rhkean/kicad_ESP32-S3_D1_Pico/ESP32-S3 Pico D1.kicad_pcb

## KiCad design ESP32-S3 Pico D1.kicad_pcb (2026-06-14)

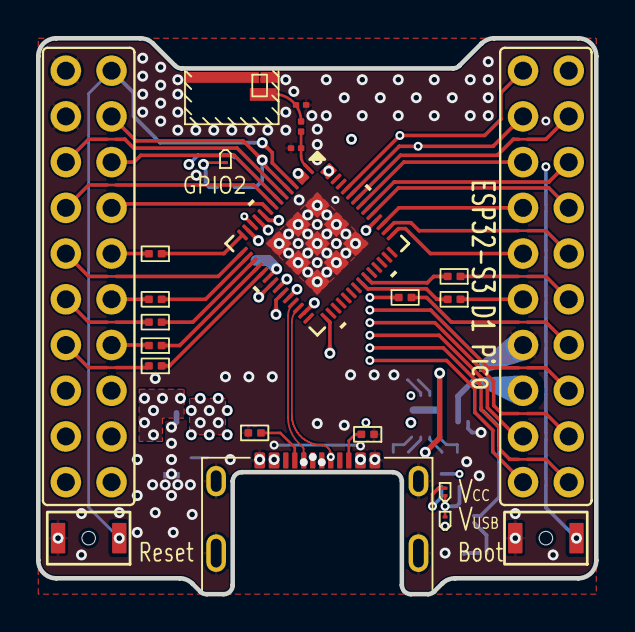
[picture p1: board ESP32-S3 Pico D1.kicad_pcb from above]

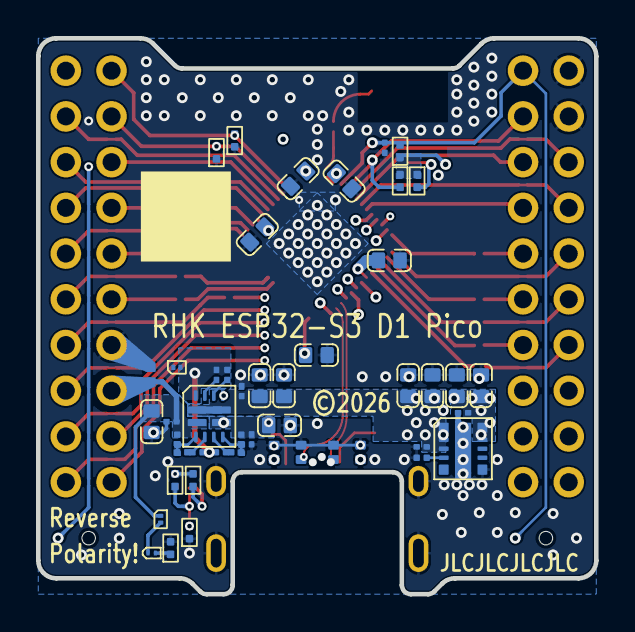
[picture p2: board ESP32-S3 Pico D1.kicad_pcb from below]

Board: 6 copper layers, 31.0 x 30.9 mm, 69 parts (47 on the bottom side), 65 nets.

Parts:
ANT401: 2450AT07A0100; Chip Antenna 0402
C401, C402, C403, C404, C405, C501, C503, C507, C508, C509, C510, C513, C514: 22uF; C_0603_Dense
C406, C407: DNP; C_0201_Dense
C502, C504, C505, C506, C511, C512, C601: 0.1uF; C_0201_Dense
CN501: GT-USB-7014D; USB_C_Receptacle_G-Switch-GT-USB-7014D
D501, D502, D505: D15V0H1U2LP-7B; DFN1006-2
D503, D504: SZESD7241N2T5G; DFN1006-2
D506, D601: PMEG4002ESFYL; DFN0603-2
LED601: Blue; LED_0201-2
LED602: Green; LED_0201-2
LED603: Orange; LED_0201-2
LED604: Red; LED_0201-2
R401, R402, R403, R404, R405, R406, R407, R408: 33R; R_0201_Nominal
R409, R410, R501, R502, R601, R602, R604, R605, R606: 5k1; R_0201_Nominal
R411: 0R; R_0201_Dense
R503, R506, R509: 100k; R_0201_Dense
R504, R505, R507, R508, R510: 26k1; R_0201_Dense
R603, R607: 470R; R_0201_Nominal
SW601, SW602: SPST-NO; SW_SPST_B3U_series
U201: ESP32-S3_D1_Pico
U401: ESP32-S3-PICO-1-N8R2; ESP32-S3-Pico-1
U501: TPS2121; VQHN-HR-12
U502: TPSM82903; uSIP-11_3.0x2.8

Connections:
/+5V_{EXT}: C501.1, C502.1, D505.1 (K), D601.1 (K), R506.1, U201.28 (+5V_{EXT}), U501.2 (IN2)
/ESP32-S3 Pico D1-Main/+3V3: C401.1, C402.1, C403.1, C404.1, C405.1, C512.1, C513.1, C514.1, R601.1, R602.1, R603.1, R604.2, R606.2, U201.8 (+3V3_{out}), U201.18 (+3V3), U401.2 (VDD3P3), U401.3 (VDD3P3), U401.20 (VDD3P3_RTC), U401.29 (VDD_SPI), U401.46 (VDD3P3_CPU), U401.55 (VDDA), U401.56 (VDDA), U502.9 (VOUT), U502.10 (VOUT)
/ESP32-S3 Pico D1-Main/+5V_{FUSED}: C506.1, C507.1, C508.1, C509.1, C510.1, C511.1, U201.9 (+5V_{FUSED_{out}}), U501.1 (OUT), U501.8 (OUT), U502.1 (VIN), U502.2 (VIN), U502.3 (EN)
/ESP32-S3 Pico D1-Main/EN/~Reset: C601.1, R601.2, SW601.1, U201.11 (EN/~RST), U401.4 (CHIP_PU)
/ESP32-S3 Pico D1-Main/ESP32-S3-PICO-1/GPIO09: R401.1, U401.14 (GPIO09)
/ESP32-S3 Pico D1-Main/ESP32-S3-PICO-1/GPIO11: R402.1, U401.16 (GPIO11)
/ESP32-S3 Pico D1-Main/ESP32-S3-PICO-1/GPIO12: R403.1, U401.17 (GPIO12)
/ESP32-S3 Pico D1-Main/ESP32-S3-PICO-1/GPIO13: R404.1, U401.18 (GPIO13)
/ESP32-S3 Pico D1-Main/ESP32-S3-PICO-1/GPIO14: R405.1, U401.19 (GPIO14)
/ESP32-S3 Pico D1-Main/ESP32-S3-PICO-1/GPIO21: R406.1, U401.27 (GPIO21)
/ESP32-S3 Pico D1-Main/ESP32-S3-PICO-1/RF_Feed: ANT401.1 (Feed), ANT401.4 (Feed), C407.1, R411.2
/ESP32-S3 Pico D1-Main/ESP32-S3-PICO-1/RF_In: C406.1, R411.1, U401.1 (LNA_IN)
/ESP32-S3 Pico D1-Main/ESP32-S3-PICO-1/USB_D+: CN501.A6 (D+), CN501.B6 (D+), D503.1 (A1), U401.26 (GPIO20/USB_D+)
/ESP32-S3 Pico D1-Main/ESP32-S3-PICO-1/USB_D-: CN501.A7 (D-), CN501.B7 (D-), D504.1 (A1), U401.25 (GPIO19/USB_D-)
/ESP32-S3 Pico D1-Main/IO00: R602.2, SW602.1, U201.12 (IO00), U401.5 (GPIO00)
/ESP32-S3 Pico D1-Main/IO01: U201.3 (IO01), U401.6 (GPIO01)
/ESP32-S3 Pico D1-Main/IO02: LED601.1 (K), U201.13 (IO02), U401.7 (GPIO02)
/ESP32-S3 Pico D1-Main/IO03: U201.4 (IO03), U401.8 (GPIO03)
/ESP32-S3 Pico D1-Main/IO04: U201.14 (IO04), U401.9 (GPIO04)
/ESP32-S3 Pico D1-Main/IO05: U201.20 (I005), U401.10 (GPIO05)
/ESP32-S3 Pico D1-Main/IO06: U201.19 (IO06), U401.11 (GPIO06)
/ESP32-S3 Pico D1-Main/IO07: U201.10 (IO07), U401.12 (GPIO07)
/ESP32-S3 Pico D1-Main/IO08: U201.30 (IO08), U401.13 (GPIO08)
/ESP32-S3 Pico D1-Main/IO09: R401.2, U201.15 (IO09)
/ESP32-S3 Pico D1-Main/IO10: U201.5 (IO10), U401.15 (GPIO10)
/ESP32-S3 Pico D1-Main/IO11: R402.2, U201.16 (IO11)
/ESP32-S3 Pico D1-Main/IO12: R403.2, U201.6 (IO12)
/ESP32-S3 Pico D1-Main/IO13: R404.2, U201.17 (IO13)
/ESP32-S3 Pico D1-Main/IO14: R405.2, U201.7 (IO14)
/ESP32-S3 Pico D1-Main/IO15: U201.40 (IO15), U401.21 (XTAL_32K_P/GPIO15)
/ESP32-S3 Pico D1-Main/IO16: U201.39 (IO16), U401.22 (XTAL_32K_N/GPIO16)
/ESP32-S3 Pico D1-Main/IO17: U201.29 (IO17), U401.23 (GPIO17)
/ESP32-S3 Pico D1-Main/IO18: U201.38 (IO18), U401.24 (GPIO18)
/ESP32-S3 Pico D1-Main/IO21: R406.2, U201.37 (IO21)
/ESP32-S3 Pico D1-Main/IO38: U201.25 (IO38), U401.43 (GPIO38)
/ESP32-S3 Pico D1-Main/IO39: U201.35 (IO39), U401.44 (MTCK/GPIO39)
/ESP32-S3 Pico D1-Main/IO40: U201.24 (IO40), U401.45 (MTDO/GPIO40)
/ESP32-S3 Pico D1-Main/IO41: U201.34 (IO41), U401.47 (MTDI/GPIO41)
/ESP32-S3 Pico D1-Main/IO42: U201.33 (IO42), U401.48 (MTMS/GPIO42)
/ESP32-S3 Pico D1-Main/IO43: U201.23 (IO43), U401.49 (U0TXD/GPIO43)
/ESP32-S3 Pico D1-Main/IO44: U201.32 (IO44), U401.50 (U0RXD/GPIO44)
/ESP32-S3 Pico D1-Main/IO45: R409.2, U201.22 (IO45), U401.51 (GPIO45)
/ESP32-S3 Pico D1-Main/IO46: R410.2, U201.21 (IO46), U401.52 (GPIO46)
/ESP32-S3 Pico D1-Main/IO47: R407.1, U201.36 (IO47)
/ESP32-S3 Pico D1-Main/IO48: R408.1, U201.26 (IO48)
/ESP32-S3 Pico D1-Main/USB_Power_Interface/+V_{BUS}: C503.1, C504.1, CN501.A4 (VBUS), CN501.A9 (VBUS), CN501.B4 (VBUS), CN501.B9 (VBUS), D501.1 (K), D502.1 (K), R503.1, U501.7 (IN1)
/ESP32-S3 Pico D1-Main/USB_Power_Interface/CC1: CN501.A5 (CC1), R502.2
/ESP32-S3 Pico D1-Main/USB_Power_Interface/CC2: CN501.B5 (CC2), R501.2
/ESP32-S3 Pico D1-Main/USB_Power_Interface/CP2: R506.2, R507.2, U501.3 (CP2)
/ESP32-S3 Pico D1-Main/USB_Power_Interface/GND1: C505.2, D506.2 (A), R505.1, R508.1, R509.2, U501.12 (GND)
/ESP32-S3 Pico D1-Main/USB_Power_Interface/ILM: R509.1, U501.10 (ILM)
/ESP32-S3 Pico D1-Main/USB_Power_Interface/OV1: R504.1, R505.2, U501.5 (OV1)
/ESP32-S3 Pico D1-Main/USB_Power_Interface/OV2: R507.1, R508.2, U501.4 (OV2)
/ESP32-S3 Pico D1-Main/USB_Power_Interface/PR1: R503.2, R504.2, U501.6 (PR1)
/ESP32-S3 Pico D1-Main/USB_Power_Interface/Pwr Src Ind: LED602.2 (A), LED603.1 (K), R604.1, U501.9 (ST)
/ESP32-S3 Pico D1-Main/USB_Power_Interface/SCONFd: R510.2, U502.4 (SCONF)
/ESP32-S3 Pico D1-Main/USB_Power_Interface/SS: C505.1, U501.11 (SS)
/ESP32-S3 Pico D1-Main/User Interface/LED1_H: LED603.2 (A), R606.1
/ESP32-S3 Pico D1-Main/User Interface/LED2_H: LED601.2 (A), R603.2
/ESP32-S3 Pico D1-Main/User Interface/LED3_L: LED602.1 (K), R605.2
/ESP32-S3 Pico D1-Main/User Interface/LED4_H: LED604.2 (A), R607.1
/ESP32-S3 Pico D1-Main/User Interface/LED4_L: D601.2 (A), LED604.1 (K)
/GND: ANT401.2 (GND), ANT401.3 (GND), C401.2, C402.2, C403.2, C404.2, C405.2, C406.2, C407.2, C501.2, C502.2, C503.2, C504.2, C506.2, C507.2, C508.2, C509.2, C510.2, C511.2, C512.2, C513.2, C514.2, C601.2, CN501.A1 (GND), CN501.A12 (GND), CN501.B1 (GND), CN501.B12 (GND), CN501.S1 (SHIELD), CN501.S2 (SHIELD), CN501.S3 (SHIELD), CN501.S4 (SHIELD), D501.2 (A), D502.2 (A), D503.2 (A2), D504.2 (A2), D505.2 (A), D506.1 (K), R409.1, R410.1, R501.1, R502.1, R510.1, R605.1, R607.2, SW601.2, SW602.2, U201.1 (GND), U201.2 (GND), U201.27 (GND), U401.57 (GND), U502.6 (PG), U502.11 (GND)
unnamed: R408.2, U401.36 (SPICLK_N/GPIO48)
unnamed: R407.2, U401.37 (SPICLK_P/GPIO47)
