rhkean/kicad_ESP32-S3_D1_Pico/(commit log)

2026-03-13 streamlined routing by discarding legacy GPIO pinout compatibility. reduced Vin to Vcc and Vbus (no more +16V) includes CAN & Vehicle inputs (need to move to 2nd board, though) added wake-on-start by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
    [CAN_Interface.kicad_sch, ESP32-S3 Pico D1.kicad_pcb, ESP32-S3 Pico D1.kicad_sch, ESP32-S3-PICO-1.kicad_sch, USB_Power_Interace.kicad_sch, USB_Power_Interface.kicad_sch, User_Interface.kicad_sch]
2026-03-25 Update .gitignore, BOM-ESP32-S3 Pico D1.csv, CANBus_Interface.kicad_sch, and 14 more files
    [BOM-ESP32-S3 Pico D1.csv, CANBus_Interface.kicad_sch, CAN_Interface.kicad_sch, ESP32-S3 D1 Pico Board.kicad_sch, ESP32-S3 Pico D1.kicad_pcb, ESP32-S3 Pico D1.kicad_sch, ESP32-S3-PICO-1.kicad_sch, GR86_Inputs.kicad_sch]
2026-03-26 removed BOM-ESP32-S3 Pico D1.csv, created WLED_UnderGlow_AI_Skill.md, BOM_Sync_Skill.md and ai-instructions.md CoPilot configurations WLED UnderGLow.md updated WLED\ UnderGlow.md
    [BOM-ESP32-S3 Pico D1.csv]
2026-04-23 Update CANBus_Interface.kicad_sch, ESP32-S3 D1 Pico Board.kicad_sch, ESP32-S3 Pico D1.kicad_pcb, and 15 more files
    [CANBus_Interface.kicad_sch, ESP32-S3 D1 Pico Board.kicad_sch, ESP32-S3 Pico D1.kicad_pcb, ESP32-S3 Pico D1.kicad_sch, ESP32-S3-PICO-1.kicad_sch, GR86_Inputs.kicad_sch, IO_Board.kicad_sch, SPI_and_GBL_FLT.kicad_sch]
2026-05-06 Update CAN_Interface.kicad_sch, ESP32-S3 D1 Pico Board.kicad_sch, ESP32-S3 Pico D1.kicad_pcb, and 5 more files
    [CAN_Interface.kicad_sch, ESP32-S3 D1 Pico Board.kicad_sch, ESP32-S3 Pico D1.kicad_pcb, ESP32-S3 Pico D1.kicad_sch, ESP32-S3-PICO-1.kicad_sch, User_Interface.kicad_sch]
2026-05-06 removed CANBus_Interface.kicad_sch, CAN_Interface.kicad_sch, GR86_Inputs.kicad_sch, and 3 more files
    [CANBus_Interface.kicad_sch, CAN_Interface.kicad_sch, GR86_Inputs.kicad_sch, IO_Board.kicad_sch, SPI_and_GBL_FLT.kicad_sch, WLED_Outputs.kicad_sch]
2026-05-06 Update ESP32-S3 Pico D1.kicad_pcb and ESP32-S3 Pico D1.kicad_pro
    [ESP32-S3 Pico D1.kicad_pcb]
2026-05-07 fixed hierarchical sheets; replaced pin headers with ESP32-S3_D1_Pico symbol
    [ESP32-S3 D1 Pico Board.kicad_sch, ESP32-S3 Pico D1.kicad_sch, ESP32-S3-PICO-1.kicad_sch, USB_Power_Interface.kicad_sch, User_Interface.kicad_sch]
2026-05-07 added new ESP32-S3 D1 Pico symbol and footprint
    [ESP32-S3 Pico D1.kicad_pcb]
2026-06-05 Update ESP32-S3 Pico D1-Main.kicad_sch, ESP32-S3 Pico D1.kicad_pcb, ESP32-S3 Pico D1.kicad_prl, and 7 more files
    [ESP32-S3 Pico D1-Main.kicad_sch, ESP32-S3 Pico D1.kicad_pcb, ESP32-S3 Pico D1.kicad_sch, ESP32-S3-PICO-1.kicad_sch, USB_Power_Interface.kicad_sch, User_Interface.kicad_sch]
2026-06-14 JLCPCB: W2026060405431160 2026-06-03 PCB: Y61-5297522A PCBA: SMT026060363646-5297522A
    [ESP32-S3 Pico D1.kicad_pcb]
2026-06-14 Update BOM-ESP32-S3 Pico D1.csv, CPL-ESP32-S3 Pico D1.csv, and GERBER-ESP32-S3 Pico D1.zip
    [BOM-ESP32-S3 Pico D1.csv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]
