rhkean/kicad_ESP32-S3_D1_Pico/(notices)

Notices in the files:
ESP32-S3 Pico D1.kicad_pcb:
©2026
